DalFSAE/vehicle-control-unit/README.md

<!-- PROJECT LOGO -->
<br />
<div align="center">
  <a href="https://github.com/github_username/repo_name">
    
  </a>

<h3 align="center">Real Time Vehicle Control Unit</h3>

  <p align="center">
    DMS-RTOS-VCU
    <br />
    <a href="https://github.com/AshtonDudley/DMS-RTOS-VCU"><strong>Explore the project »</strong></a>
    <br />
  </p>
</div>

<!-- GETTING STARTED -->
## Getting Started

To get a local copy up and running follow these steps.

### Prerequisites

This is an example of how to list things you need to use the software and how to install them.
* VSCode with the following extensions:
  ```sh
  STM32 VS Code Extension (https://marketplace.visualstudio.com/items?itemName=stmicroelectronics.stm32-vscode-extension)
  Cortex-Debug (https://marketplace.visualstudio.com/items?itemName=marus25.cortex-debug)
  ```
* STM32Cube Tools
    ```sh
    STM32CubeMX (https://www.st.com/en/development-tools/stm32cubemx.html)
    STM32CubeCLT (https://www.st.com/en/development-tools/stm32cubeclt.html)
    ```
* Arm GNU Toolchain
    ```sh
    https://developer.arm.com/downloads/-/arm-gnu-toolchain-downloads
    ```

### Installation
<!--
1. Get a free API Key at [https://example.com](https://example.com)
2. Clone the repo
   ```sh
   git clone https://github.com/github_username/repo_name.git
   ```
3. Install NPM packages
   ```sh
   npm install
   ```
4. Enter your API in `config.js`
   ```js
   const API_KEY = 'ENTER YOUR API';
   ```

<p align="right">(<a href="#readme-top">back to top</a>)</p>
-->

<!-- USAGE EXAMPLES -->
<!--
## Usage

Use this space to show useful examples of how a project can be used. Additional screenshots, code examples and demos work well in this space. You may also link to more resources.
*** _For more examples, please refer to the [Documentation](https://example.com)_

<p align="right">(<a href="#readme-top">back to top</a>)</p>
-->

<!-- CONTRIBUTING -->
## Contributing 
1. Create your Feature Branch (`git checkout -b feature/AmazingFeature`)
2. Commit your Changes (`git commit -m 'Add some AmazingFeature'`)
3. Push to the Branch (`git push origin feature/AmazingFeature`)
4. Open a Pull Request

## Continuous Integration

GitHub Actions validates the firmware build on every push and pull request using the existing CMake `Debug` preset.

To run the same build locally:

```sh
cmake --preset Debug
cmake --build --preset Debug
```

<p align="right">(<a href="#readme-top">back to top</a>)</p>
