DalFSAE/vehicle-control-unit/docs/arm-support.md

# Summary

Building and flashing the project on ARM

## Notes

- Offical ST CLI tool does not work on arm
- Solution, use OpenOCD instead

## Commands Used

```
sudo apt install openocd gcc-arm-none-eabi gdb-multiarch
```
