DalFSAE/vehicle-control-unit/docs/can.md

# CAN Network Design

See also `DalFSAE/can-db` for full documentation.

## Nodes

### can0

- VCU
- INV
- BMS
- HVC
- DASH
- EMETER
- CHRG

### can1

Reserved for future use
