DalFSAE/vehicle-control-unit/docs/architecture/Torque_Control_Process.drawio.pdf

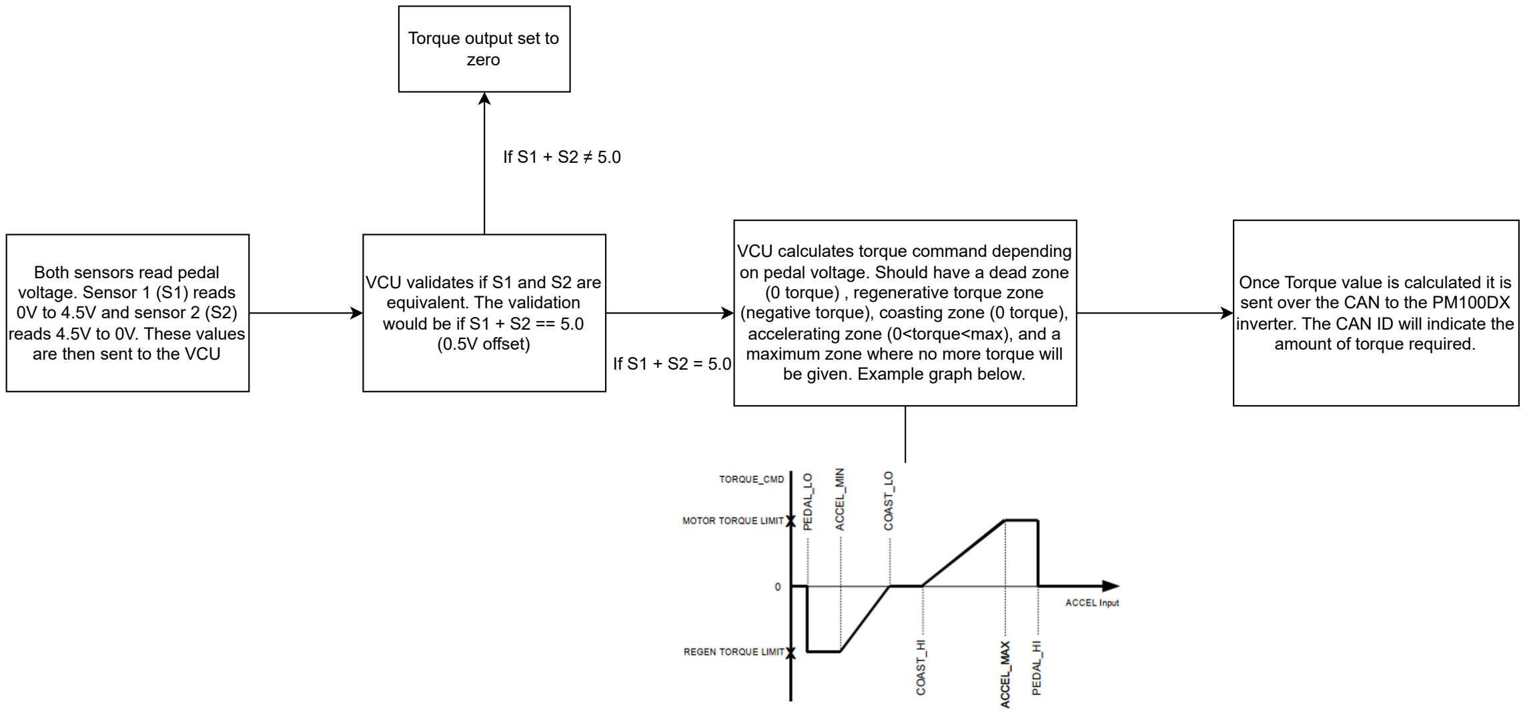
[picture p1: figure]
Both sensors read pedal voltage. Sensor 1 (S1) reads 0V to 4.5V and sensor 2 (S2) reads 4.5V to 0V. These values are then sent to the VCU; VCU validates if S1 and S2 are equivalent. The validation would be if S1 + S2 == 5.0 (0.5V offset); Torque output set to zero; VCU calculates torque command depending; (0 torque) , regenerative torque zone; accelerating zone (0<torque<max), and a maximum zone where no more torque will be given. Example graph below.; Once Torque value is calculated it is sent over the CAN to the PM100DX inverter. The CAN ID will indicate the amount of torque required.

on pedal voltage. Should have a dead zone

(negative torque), coasting zone (0 torque),
