DalFSAE/vehicle-control-unit/scripts/README.md

# Scripts

## Shell

- `can-monitor.sh` — Monitor CAN traffic via USB adapter
- `serial-monitor.sh` — Monitor VCU serial output

## HIL Testing

See [`tools/`](../tools/README.md) for the hardware-in-the-loop test harness.
