DalFSAE/vehicle-control-unit/docs/architecture/VCU_State_Machine_Diagram.png

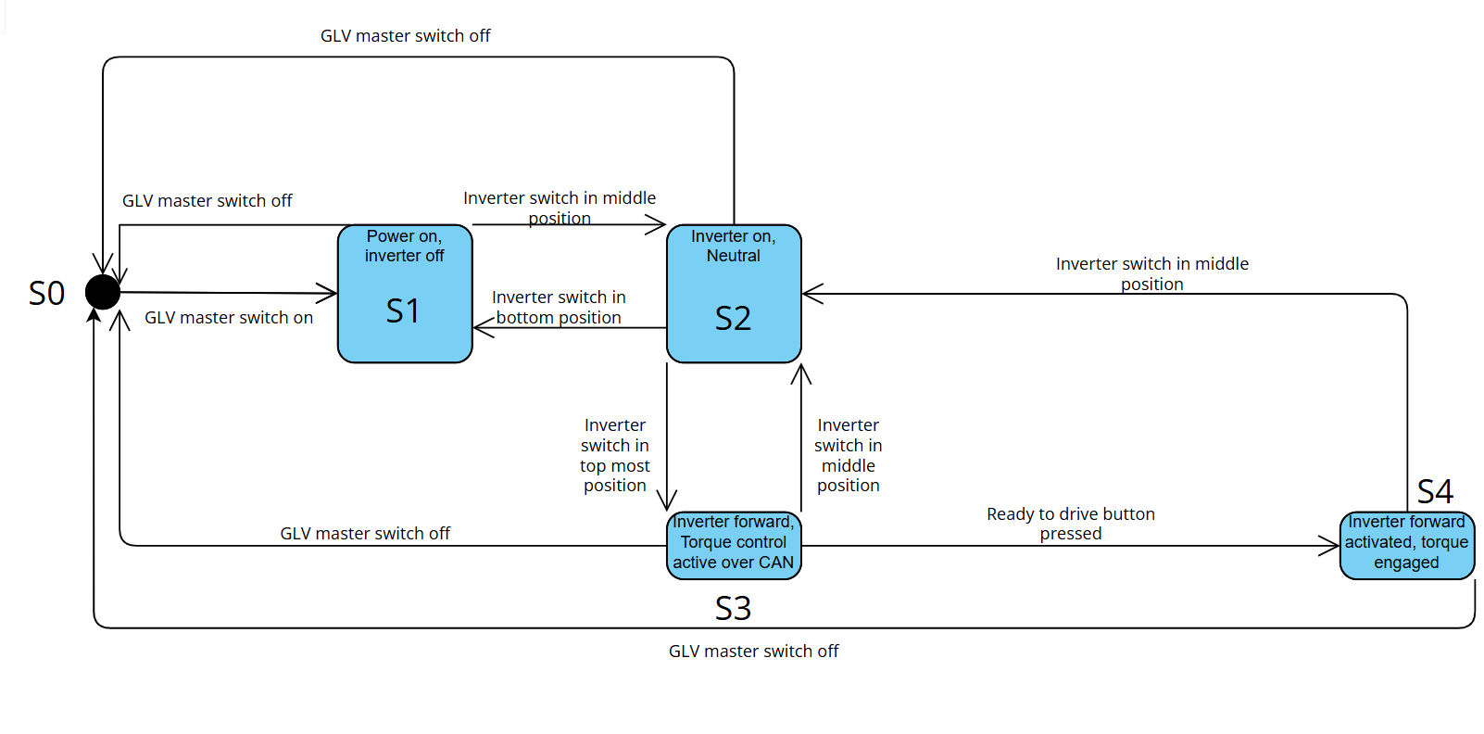
docs/architecture/VCU_State_Machine_Diagram.png
