DalFSAE/vehicle-control-unit/docs/hil-testing.md

# Summary

Hardware-tn-theLoop Testing Plan:

## Mock IO

Goal: create interface to mock the VCUs analog and digitail input/output 

- [ ] Mock apps and brake pressure signals 
- [ ] Mock 

## Mock Tractive System

Goal: provide an interface to a mock tractive system.

- [ ] Interoperate with `DalFSAE/data-and-telemetry` python package
- [ ] Mock CAN responses
- [ ] Mock analog inputs
