DalFSAE/vehicle-control-unit/docs/hardware-revisions.md

# Hardware Revisions

See [Altium 365 (sign in required)](https://americas-dalhousie-formula-sae-dalhousie-university.365.altium.com/designs/folder-CD361B6F-5C06-4D45-AAB6-D6B089EAB05A) for PCB design files.

## Version Code

Meaning:

v1.0.0

## Past Hardware

Only includes manufactured prototypes

| version | vehicle | notes |
| --- | --- | --- |
| v1.0.0  | DMS-24  | did-not-function |
| v1.1.0  | DMS-24  | used at FHE 2024 |
| v2.1.0  | DMS-25  | used at FHE 2025 |
| v3.0.0  | DMS-27  | latest revision (BSPD integrated onto PCB) |
*vehicle control units*
