DalFSAE/vehicle-control-unit/(threads)

Thread 5 (2025-05-05):

Validate functionality of the BSPD

AshtonDudley, 2025-05-05:
The BSPD did not work reliably, and would cause the car to fail during the brakes test. This was fixed by greatly increasing the brake pressure and current signal thresholds.

AshtonDudley, 2025-05-07:
To do this, we would need to open the accumulator and pass a wire through the current sensor.

AshtonDudley, 2025-05-09:
The fault signal of the BSPD is sent to the VCU, but it is not used. It would be useful to log and display the BSPD status on the CAN bus, so that it can be used with the dash

AshtonDudley, 2025-09-03:
We should test the BSPD, and document the results here. Low priority right now, but should be considered when we start working on a new BSPD

Thread 10 (2025-05-09):

Create a V2.1 hardware revision of the VCU

AshtonDudley, 2025-05-09:
# Summary

Create a V2.1 hardware revision of the VCU

## Features

Integrate the STM32F407 onto the PCB
- Removes the need for a bulky development board
- Allows for a smaller PCB
- Easier routing

Improved IO protection
- Include functional bidirectional 5v level shifting
- IO overvoltage and overcurrent protection

More eFuse outputs
- Some of the lower current circuits can be moved to eFuses, reducing PCB size
- eFuses provide better protection in case of a short circuit

Add a 12v barrel jack input for bench development

Consider adding a relay with an exposed coil for the SDC

AshtonDudley, 2025-05-12:
todo: create a new V2.1 project

AshtonDudley, 2025-05-13:
@Lorne-Mac I added a requirements table and created a new project on Altium named DMS-26-VCU-2.2

AshtonDudley, 2025-06-09:
- APPS1 -> ACC2_OPEN -> CAN_BUS -> VCU -> CAN_BUS -> INVERTER (NEVER GOT MADE)
- APPS1 -> VCU ADC -> VCU DAC -> INVERTER (ANALOG), 200ms of throttle

Goal: Apps to invert time to be less than 25ms

## Torque Controller
- See PM100DX datasheet
- Mode 1: Analog, 0- 5V, DIN Brake, DIN Forward, DIN Reverse
- Mode 2: CAN-based control

APPS1 -> VCU: VCU -> CAN_BUS Control message -> INVERTER

Thread 9 (2025-05-09):

Implement VCU CAN bus logging

AshtonDudley, 2025-05-09:
# Summary

Implement CAN bus logging for all critical VCU information. This includes:

- Current VCU state
- All ADC inputs
- The status of all digital inputs and outputs
- Current torque output
- BSPD and Watchdog fault status
