DalFSAE/vehicle-control-unit/DMS-26-VCU-V3.0.pdf

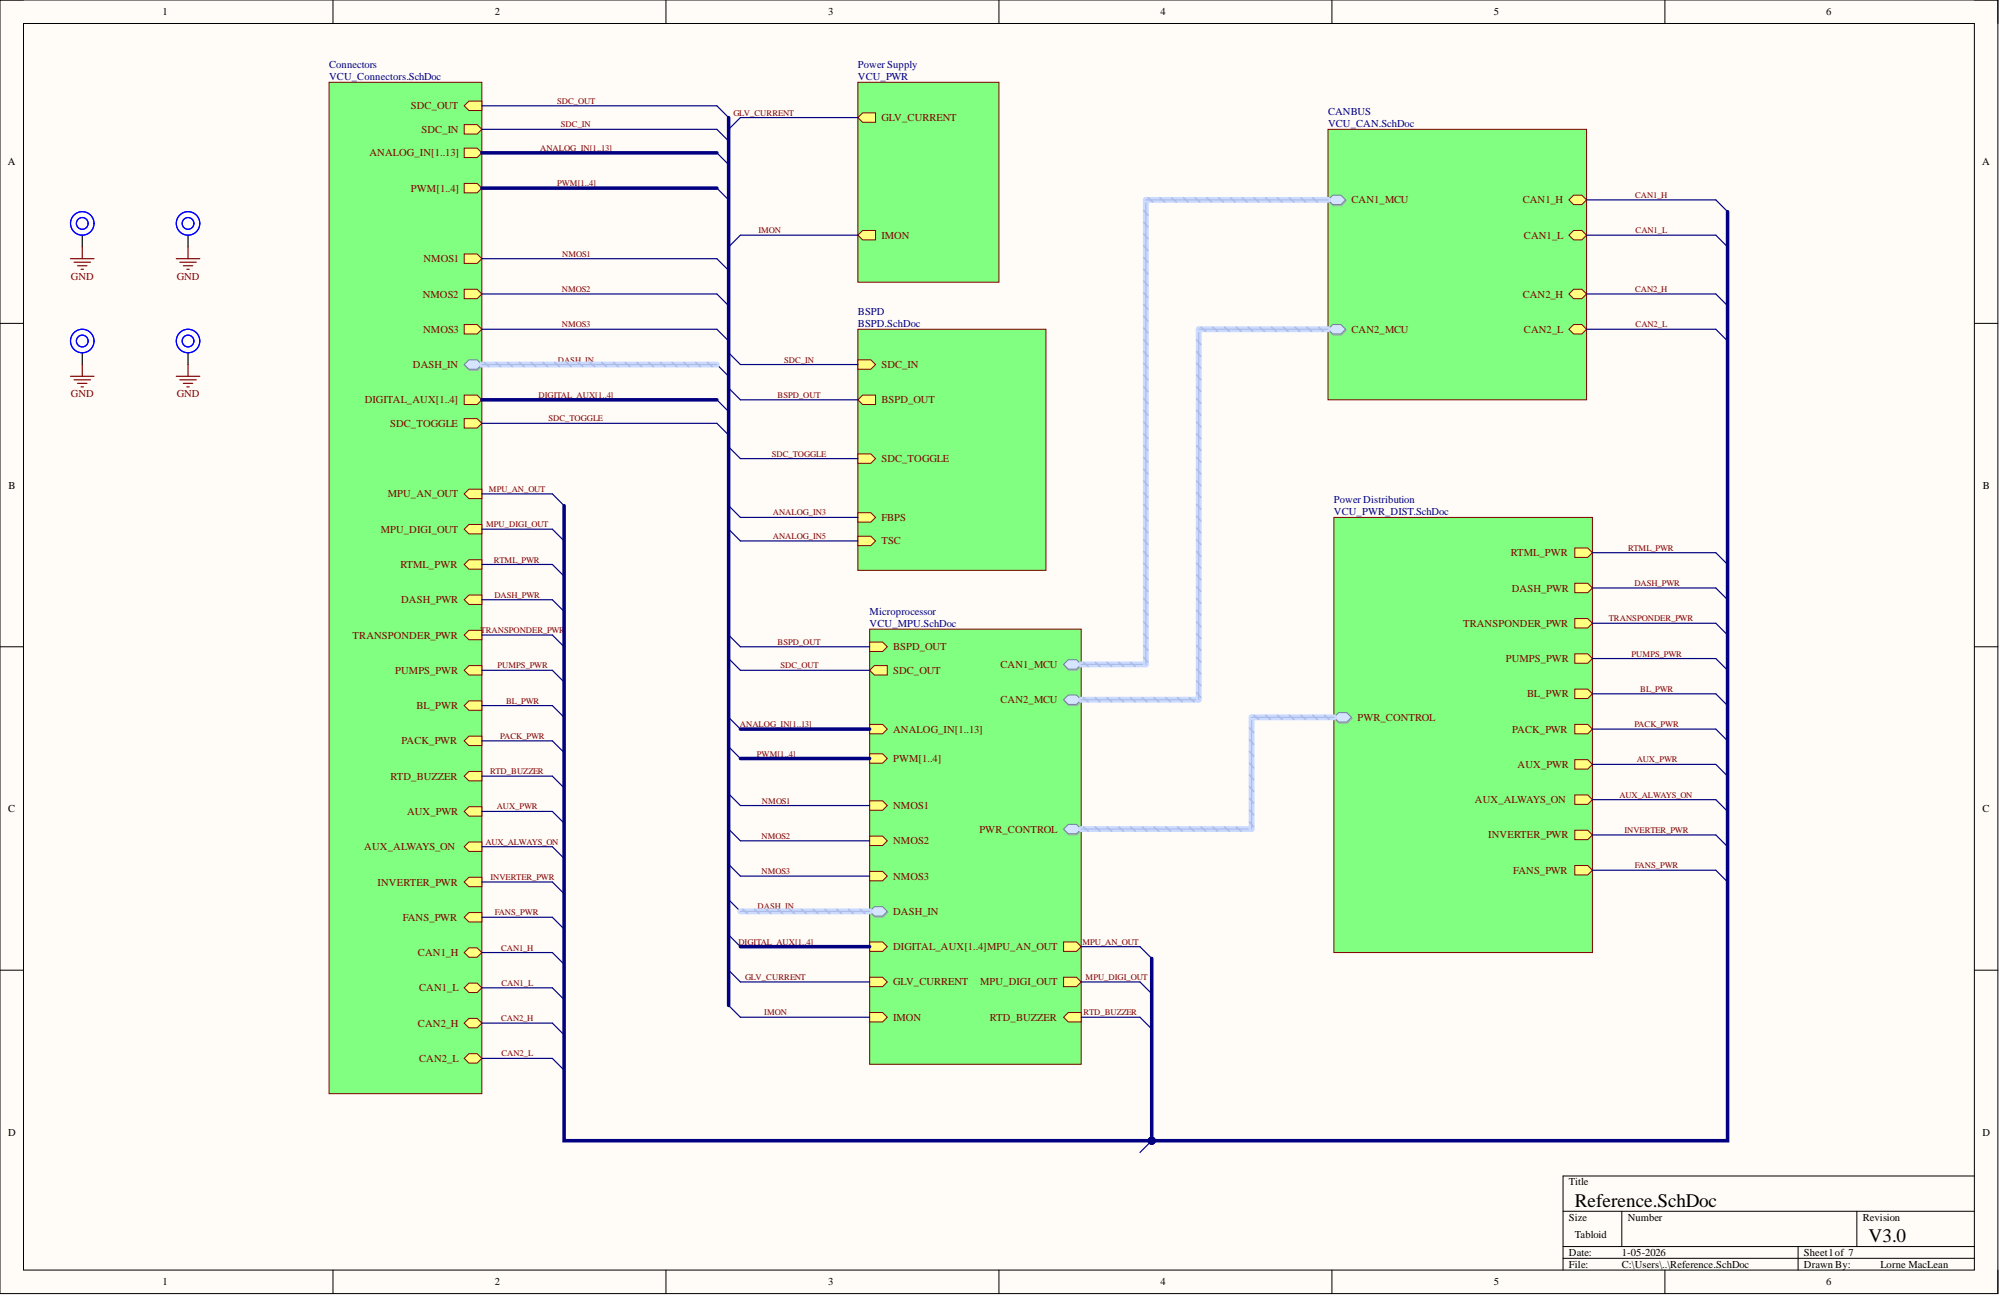
[picture p3: page 1]

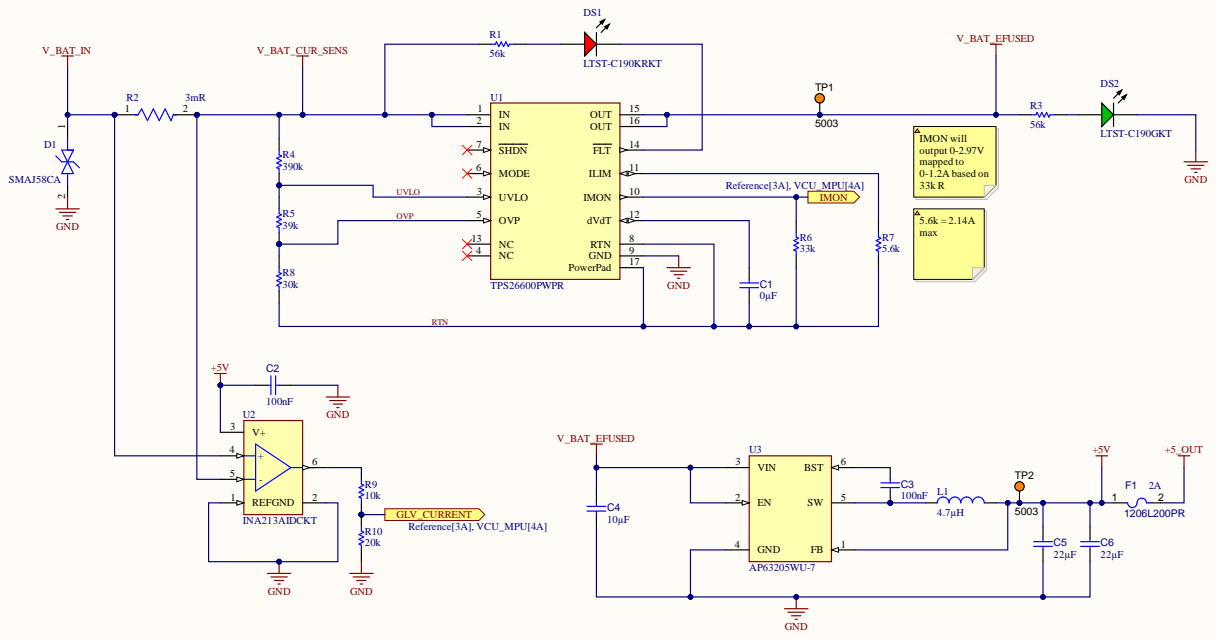
[picture p4: page 2]

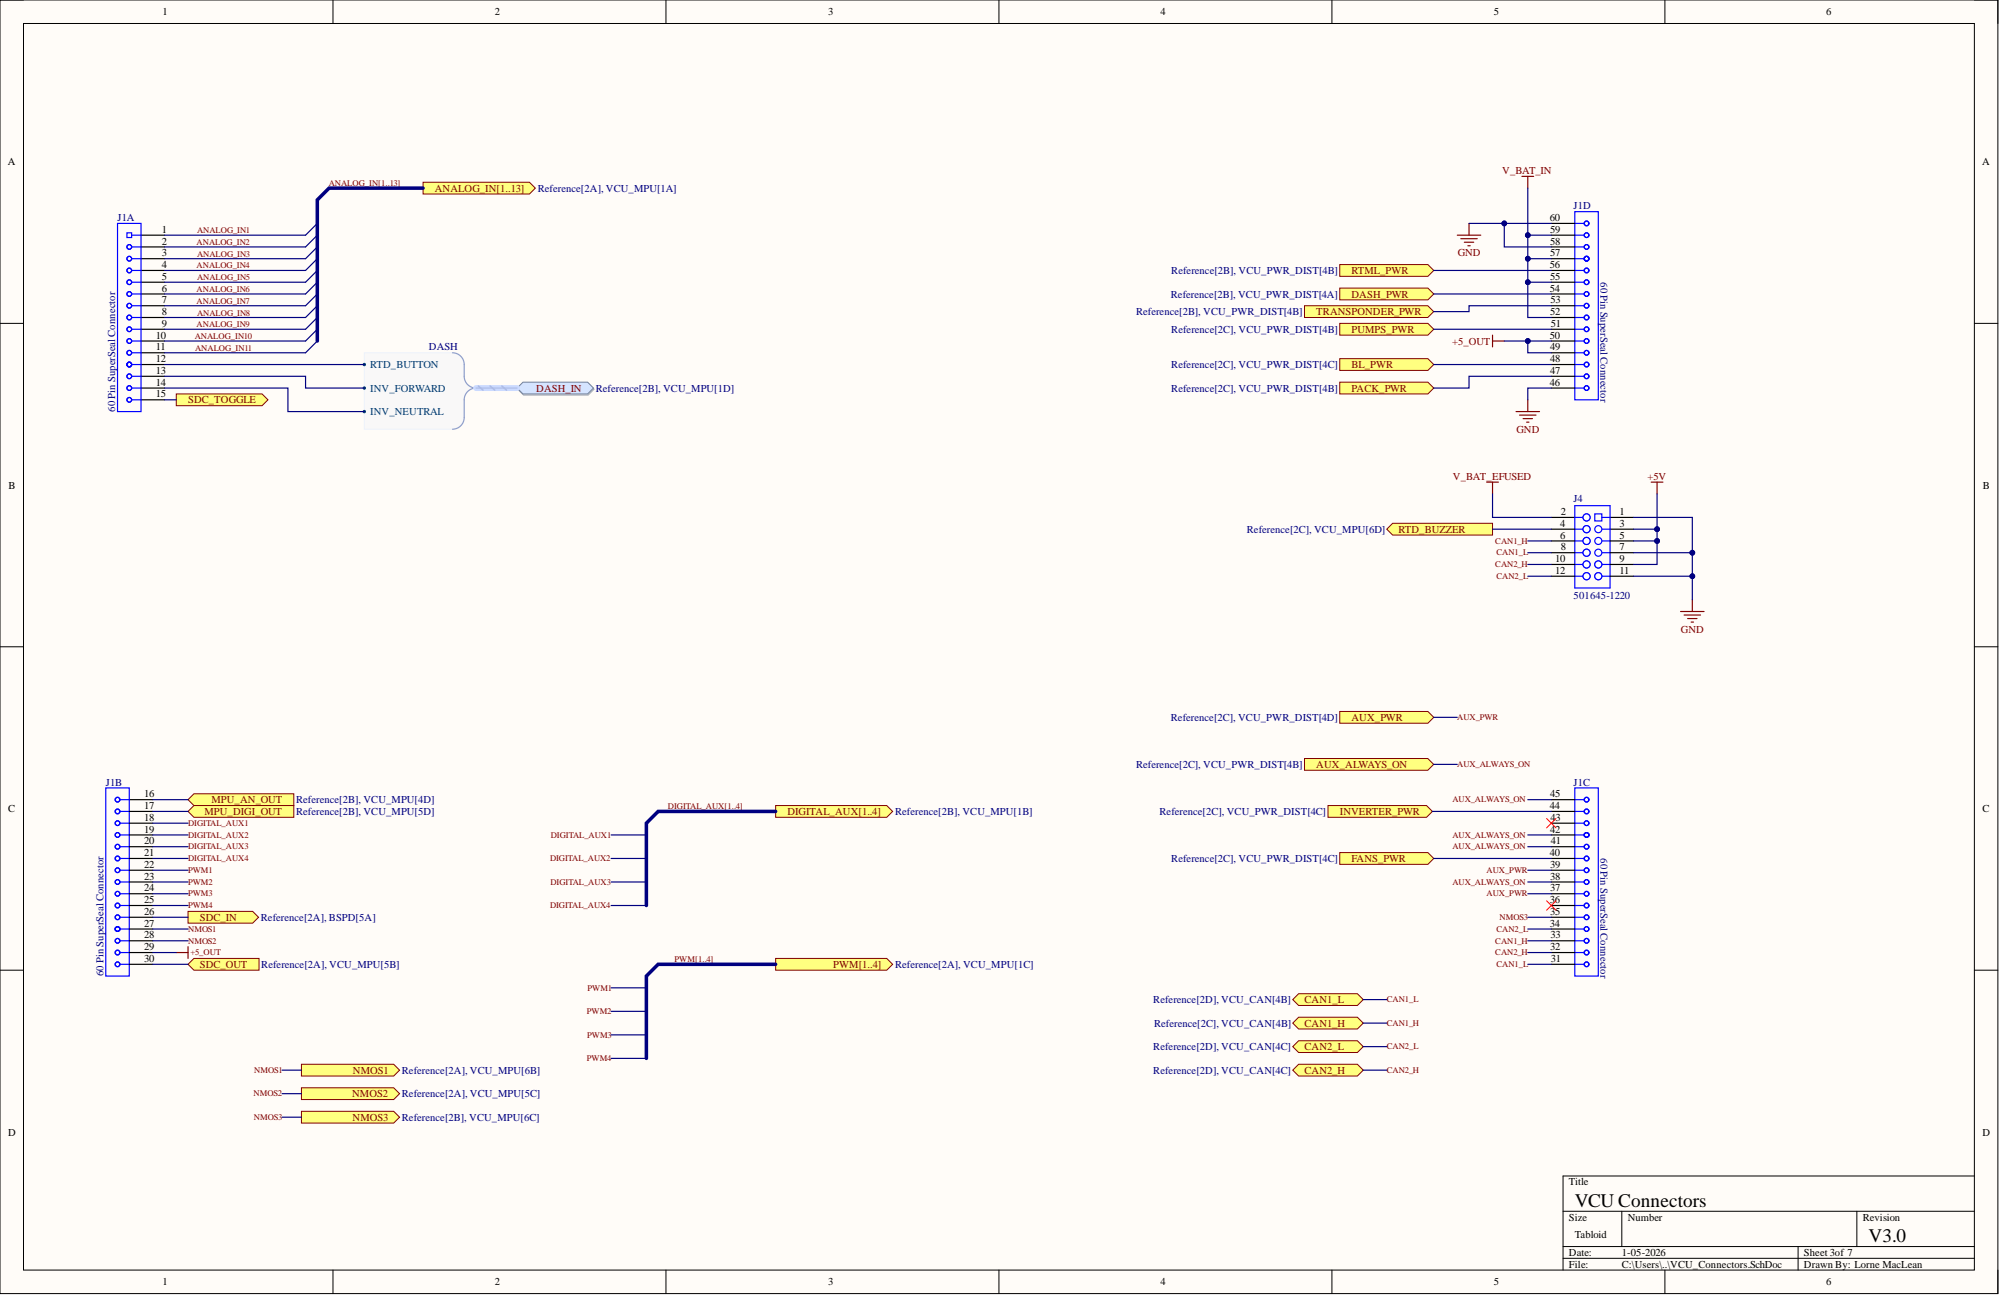
[picture p5: page 3]

SDC_TOGGLE

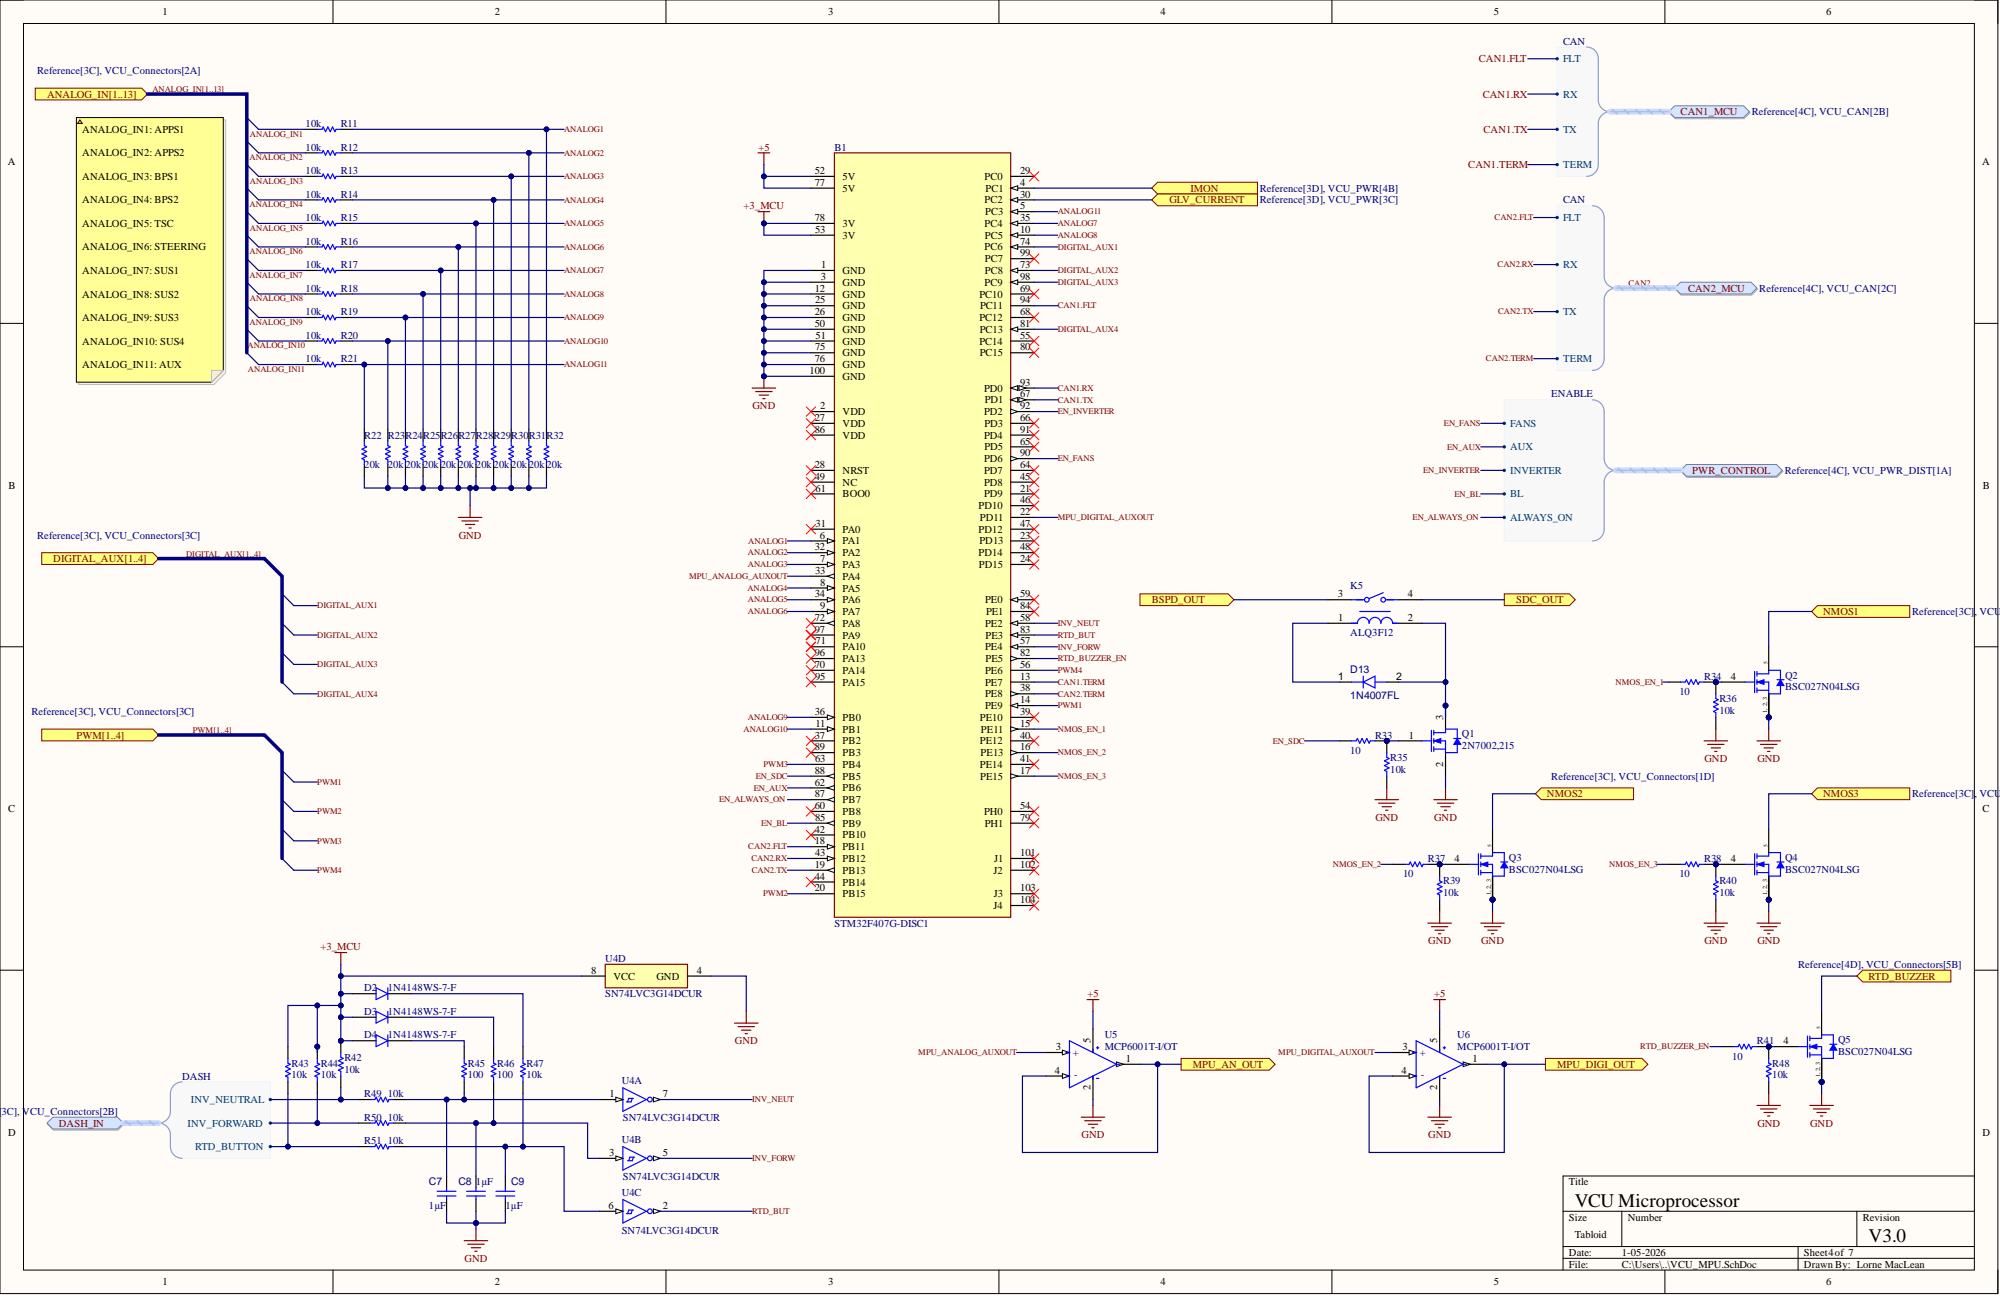
[picture p6: page 4]

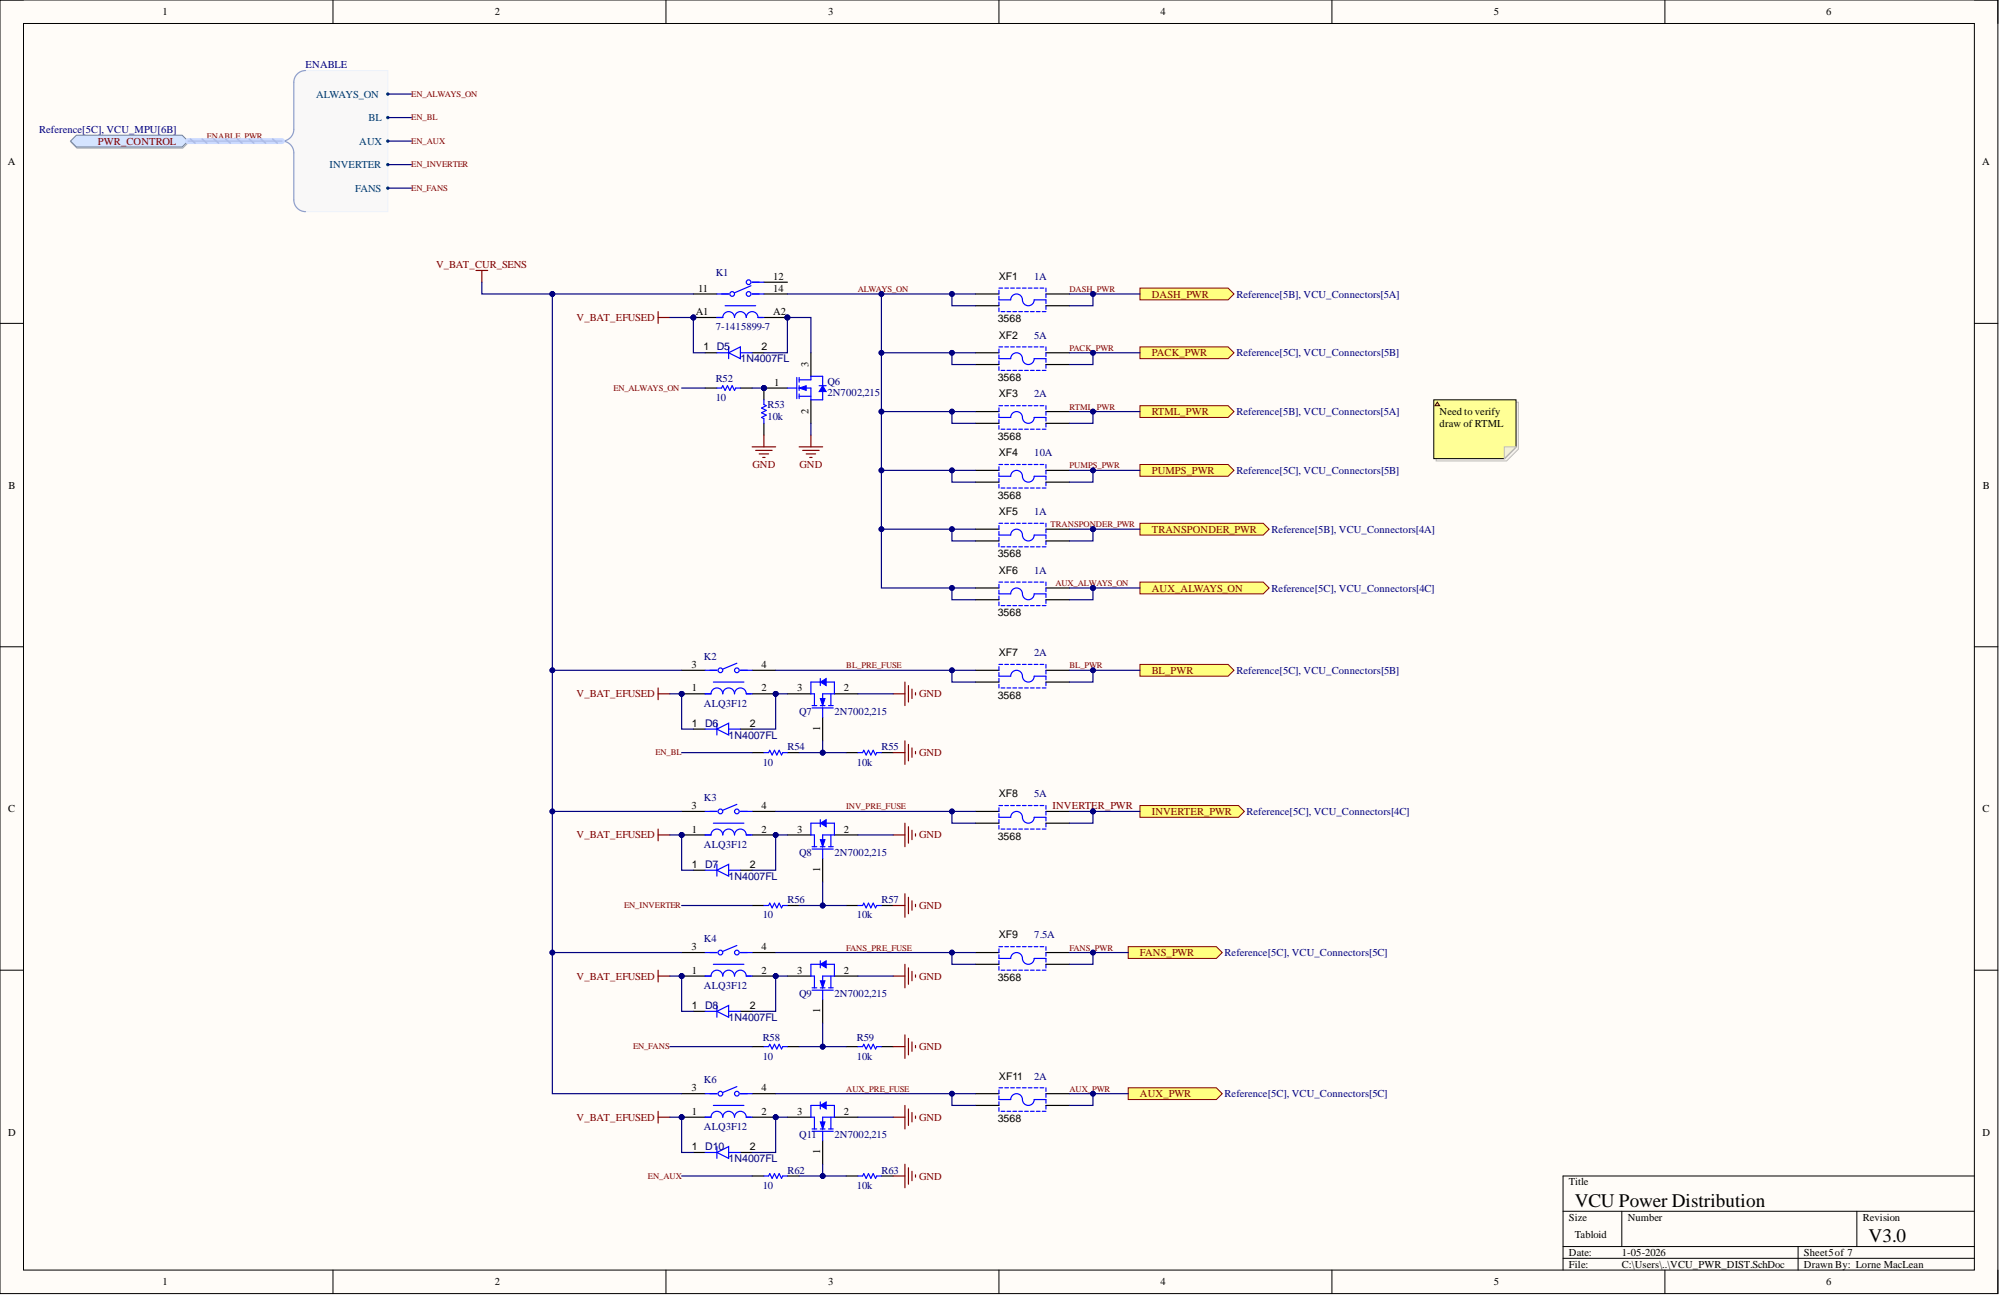
[picture p7: page 5]

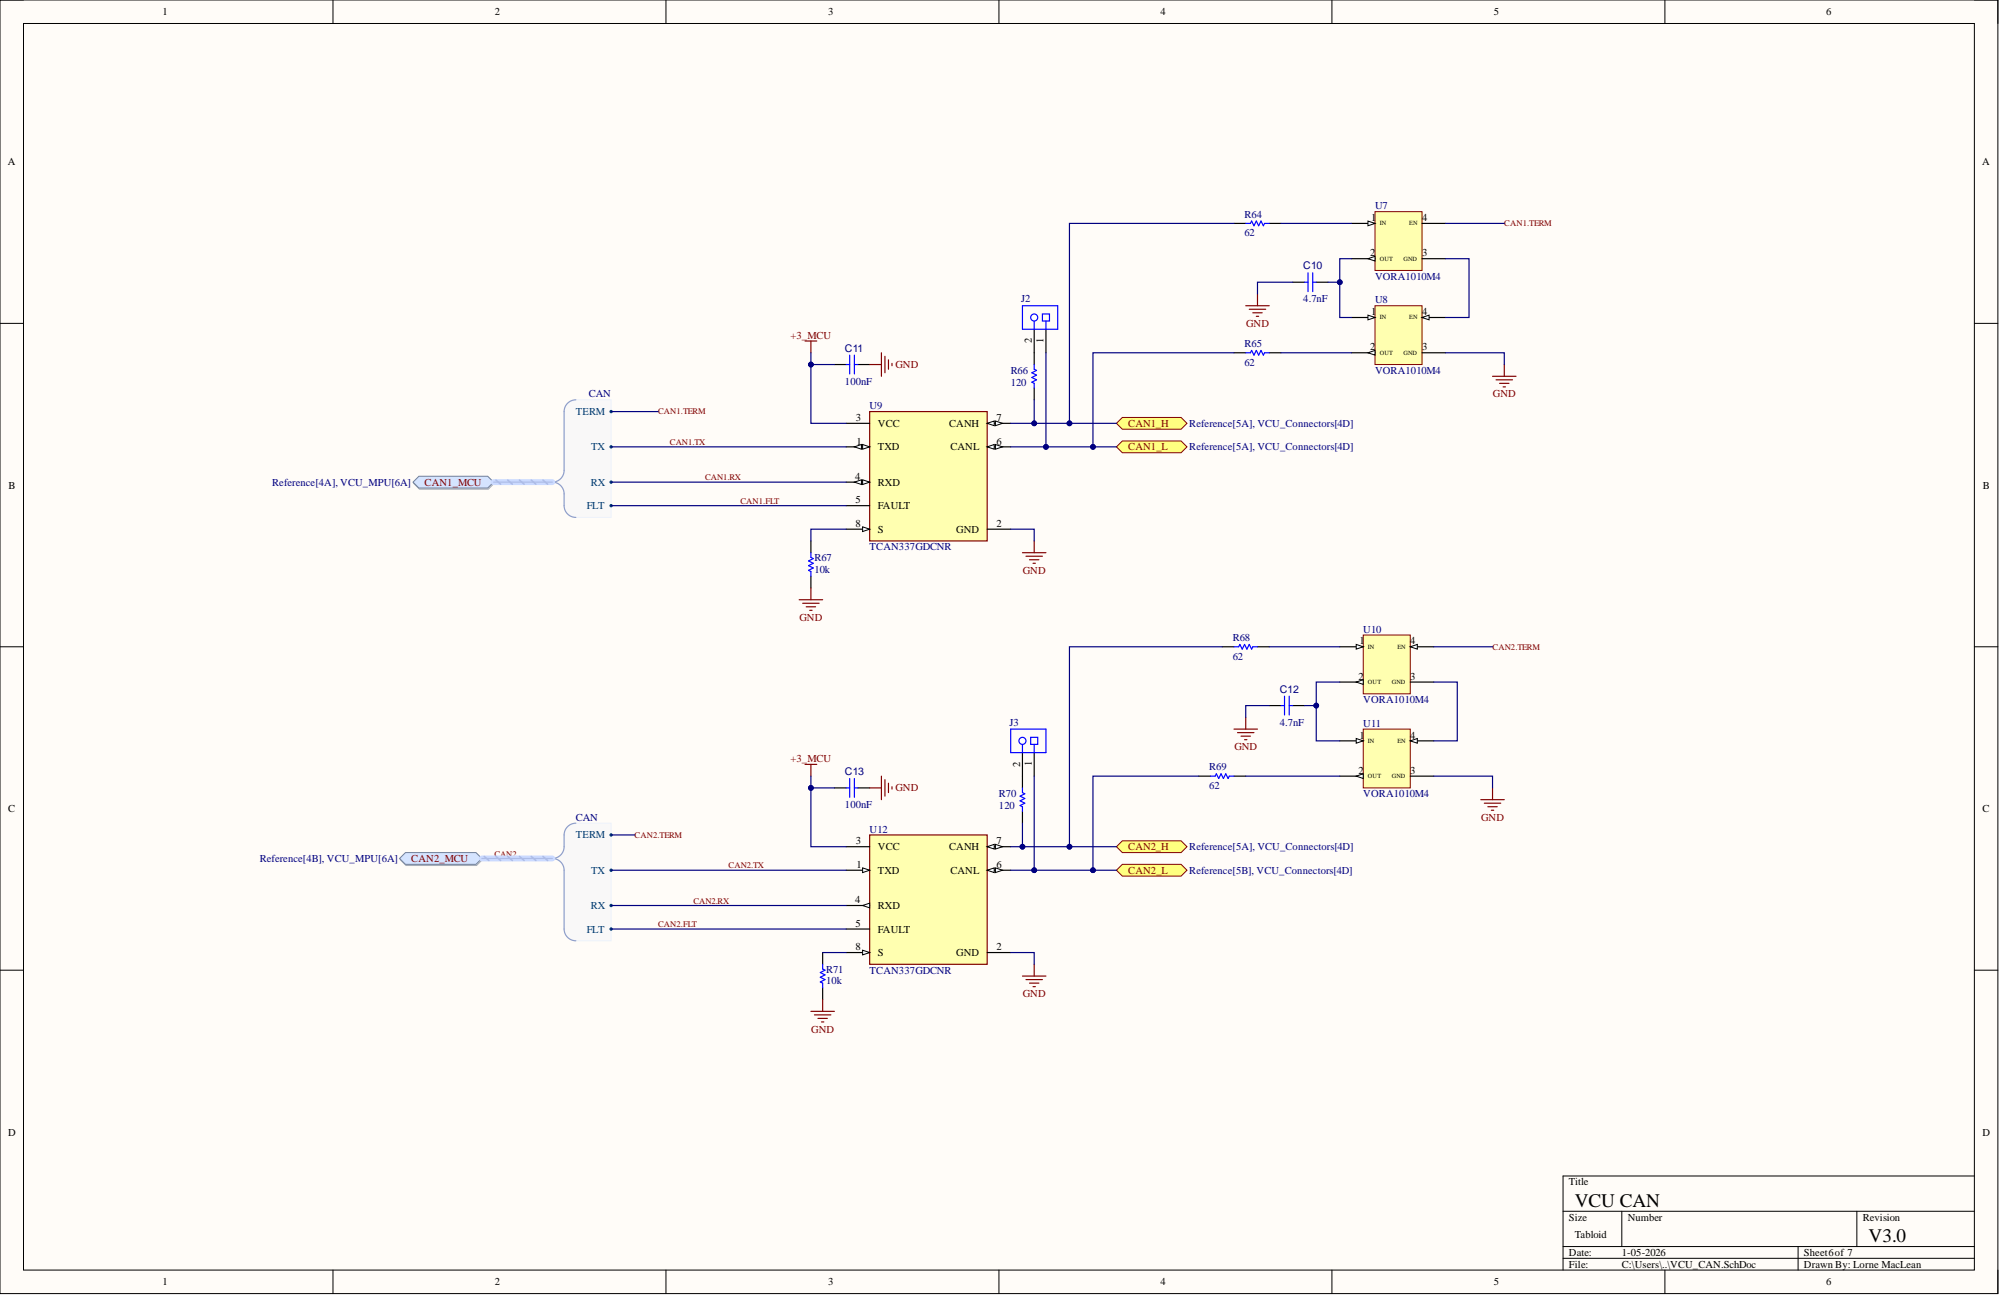
[picture p8: page 6]

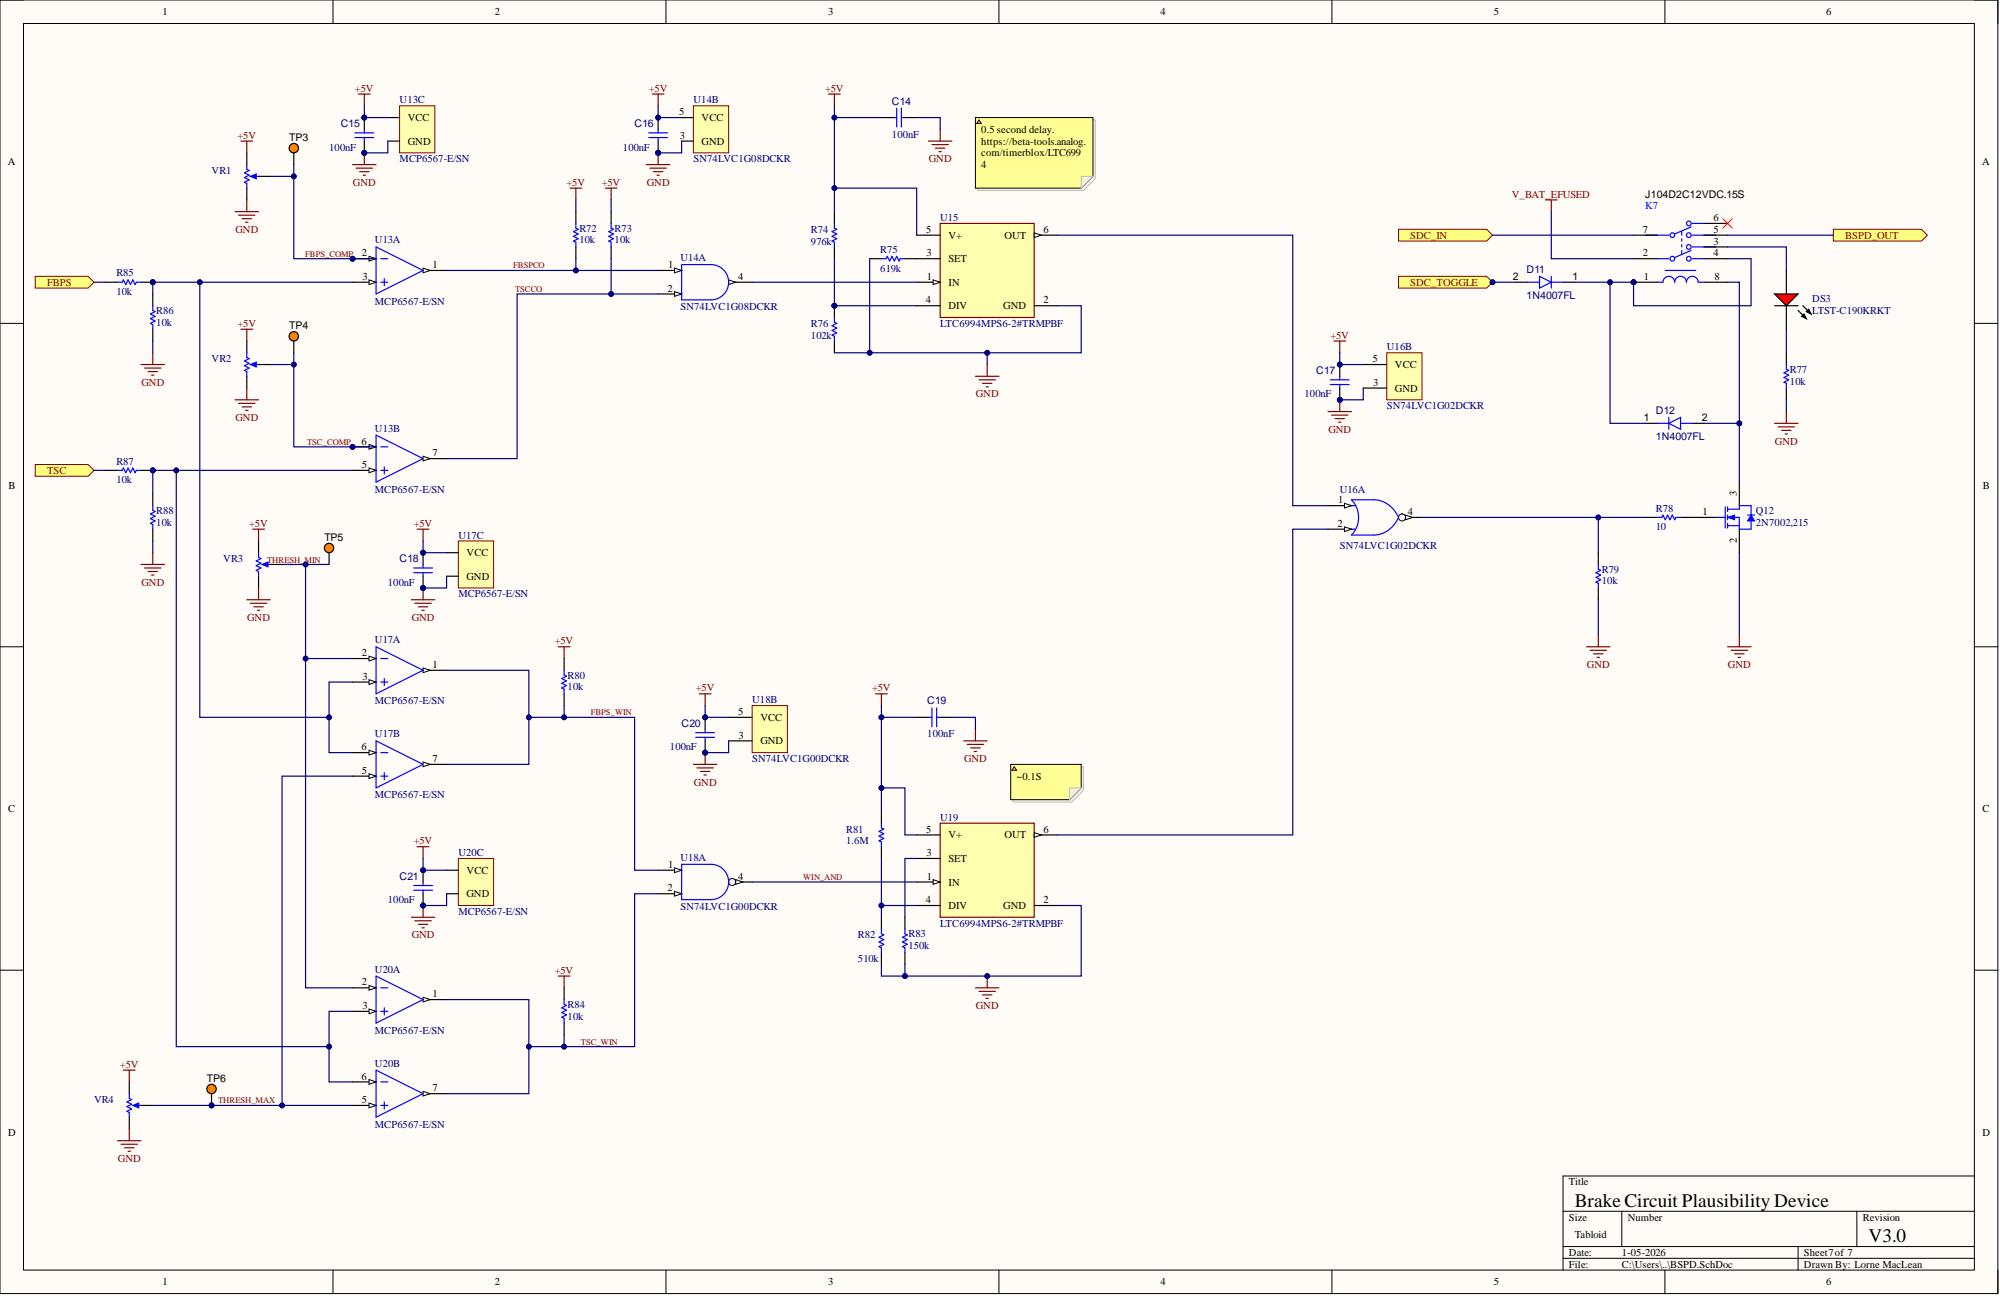
[picture p9: page 7]

Brake Circuit Plausibility Device
