DalFSAE/vehicle-control-unit/Core/User/log.h

#pragma once

#include <stdbool.h>
#include <stdint.h>

#define UART_BUF_SIZE 256
#define LOG_USB_TX_RETRY_COUNT 10U

// CAN payload layout: [event_id(1), source(1), a0[15:8](1), a0[7:0](1),
//                      a1[15:8](1), a1[7:0](1), reserved(1), reserved(1)]
// a0 and a1 are truncated to 16 bits.
#define CAN_PAYLOAD_SIZE 8U

// used to filter log verbosity level
typedef enum {
    LOG_LEVEL_DEBUG = 0u,
    LOG_LEVEL_INFO,
    LOG_LEVEL_WARN,
    LOG_LEVEL_ERROR
} LogLevel_t;

// Only events at or above this level are printed to serial.
#define LOG_MIN_LEVEL LOG_LEVEL_INFO

// List of possible firmware events
typedef enum {
    EVT_BOOT = 0u,
    EVT_STATE_CHANGE,
    EVT_FAULT_SET,
    EVT_FAULT_CLEAR,
    EVT_IO_CHANGE,
    EVT_SENSOR_DEBUG,
    EVT_RTD_ENTERED,
    EVT_COMMAND_REJECTED,
    EVT_TASK_CREATED,
    EVT_HEARTBEAT,
    EVT_FSM_RESET,
    EVT_FSM_STEP,
    EVT_COUNT // must be last
} LogEventId_t;

// List of firmware modules that can produce log events.
// Define LOG_MODULE in each .c file before including log.h:
//   #define LOG_MODULE LOG_SRC_FSM
typedef enum {
    LOG_SRC_UNKNOWN = 0u, // fallback
    LOG_SRC_APP,
    LOG_SRC_FSM,
    LOG_SRC_SENSOR,
    LOG_SRC_PEDAL,
    LOG_SRC_IO,
    LOG_SRC_CAN,
    LOG_SRC_FAULT,
    LOG_SRC_TORQUE,
    LOG_SRC_MC,
    LOG_SRC_LOG,  // log.c itself
    LOG_SRC_COUNT // keep last
} LogSource_t;

// An event is a compact, structured record of something that happened at a
// specific point in time within the firmware.
// Provides a common interface for logging events
typedef struct {
    uint32_t     time_ms;  // time of event
    LogEventId_t event_id; // event id
    LogLevel_t   level;    // verbosity level
    LogSource_t  source;   // event source
    uint32_t     a0;       // logging payload
    uint32_t     a1;       // logging payload
} LogEvent_t;

typedef struct {
    uint32_t len;
    char data[UART_BUF_SIZE];
} LogMsg_t;

// Starts the logging subsystem. Safe to call before the RTOS kernel starts;
// call again from a task context to complete OS-dependent init (mutex).
bool log_init(void);

// Primary event logger — auto-fills timestamp, routes to all sinks
bool log_write(const LogEvent_t *event);

// Optional plain-text printf-style interface for debug output
void log_printf(const char *format, ...);

// Char-at-a-time sink — buffers into lines and forwards to log_printf.
// Safe to call before log_init(); pre-init output is flushed when log_init() runs.
void log_putchar(int c);

// Convenience macro — requires LOG_MODULE to be defined before including this header.
// Falls back to LOG_SRC_UNKNOWN if LOG_MODULE is not defined.
#ifndef LOG_MODULE
#define LOG_MODULE LOG_SRC_UNKNOWN
#endif

#define LOG_EVENT(log_level_value, log_event_id_value, arg0_value, arg1_value) \
    log_write(&(LogEvent_t){                                                   \
        .event_id = (log_event_id_value),                                      \
        .level    = (log_level_value),                                         \
        .source   = LOG_MODULE,                                                \
        .a0       = (arg0_value),                                              \
        .a1       = (arg1_value),                                              \
    })

void log_usb_task(void *argument);
