DalFSAE/vehicle-control-unit/Core/User/fsm_task.c

#define LOG_MODULE LOG_SRC_FSM

#include "fsm_task.h"
#include "fsm.h"
#include "vcu_io.h"
#include "dash.h"
#include "cmsis_os2.h"
#include "log.h"

volatile FsmState_t g_fsm_state     = ST_ENTRY;
volatile bool g_fsm_step_requested  = false;
volatile bool g_fsm_reset_requested = false;

static VcuOutputs s_last_outputs = {0};

FsmState_t fsm_get_state(void) {
    return g_fsm_state;
}

const VcuOutputs *fsm_get_last_outputs(void) {
    return &s_last_outputs;
}

// Packs the boolean output fields into a bitmask for change detection and logging.
// Keep in sync with the EVT_IO_CHANGE formatter in log.c.
static uint32_t pack_outputs(const VcuOutputs *o) {
    return ((uint32_t)o->relay_always_on  << 0u)
         | ((uint32_t)o->relay_inverter   << 1u)
         | ((uint32_t)o->brake_light      << 2u)
         | ((uint32_t)o->mc_brake_sw      << 3u)
         | ((uint32_t)o->can_watchdog     << 4u)
         | ((uint32_t)o->tssi_en          << 5u)
         | ((uint32_t)o->motor_direction  << 6u)
         | ((uint32_t)o->throttle_enabled << 7u);
}

void fsm_task(void *arg) {
    (void)arg;

    const FsmFaultConfig_t fault_cfg = FaultConfig_default();

    FsmState_t state       = ST_ENTRY;
    VcuInputs in           = {0};
    VcuOutputs out         = {0};
    uint32_t prev_out_bits = UINT32_MAX; // force log on first cycle

    for (;;) {
        if (g_fsm_reset_requested) {
            g_fsm_reset_requested = false;
            LOG_EVENT(LOG_LEVEL_INFO, EVT_FSM_RESET, state, ST_ENTRY);
            state = ST_ENTRY;
            vcu_clear_spoof();
        }

        vcu_gather_inputs(&in);
        out = (VcuOutputs){0};
        out.debug_leds = in.debug_cmd;
        FsmState_t next = step_fsm(state, &fault_cfg, &in, &out);

        if (next != state) {
            LOG_EVENT(LOG_LEVEL_INFO, EVT_STATE_CHANGE, state, next);
        }

        uint32_t out_bits = pack_outputs(&out);
        if (out_bits != prev_out_bits) {
            LOG_EVENT(LOG_LEVEL_DEBUG, EVT_IO_CHANGE, out_bits, (uint32_t)(out.throttle_request * 1000.0f));
            prev_out_bits = out_bits;
        }

        s_last_outputs = out;
        state          = next;
        g_fsm_state    = state;

        vcu_apply_outputs(&out);

        if (g_fsm_step_requested) {
            g_fsm_step_requested = false;
            LOG_EVENT(LOG_LEVEL_DEBUG, EVT_FSM_STEP, state, 0);
        } else {
            osDelay(FSM_PERIOD_MS);
        }
    }
}
