DalFSAE/vehicle-control-unit/Core/Tests/hardware/test_fsm_hil.h

#pragma once

void test_fsm_in_standby_after_boot(void);
void test_fsm_standby_requires_switch_and_ts(void);
void test_fsm_transitions_to_neutral(void);
void test_fsm_rtd_requires_brake(void);
void test_fsm_rtd_with_brake_enters_forward(void);
void test_fsm_pedal_plaus_returns_to_neutral(void);
void test_if_debug_button_changes_state(void);
void test_throttle_step_response_from_nuetral(void);
void test_throttle_step_response_from_forward(void);
