DalFSAE/vehicle-control-unit/Core/Tests/hardware/test_usb_cmd.h

#pragma once

void test_usb_cmd_echo_roundtrip(void);
void test_usb_cmd_request_state(void);
void test_usb_cmd_request_outputs(void);
void test_usb_cmd_spoof_set(void);
void test_usb_cmd_step(void);
void test_usb_cmd_reset(void);
