DalFSAE/vehicle-control-unit/(commit log)

2025-04-12 Testing Relay Functions
2025-04-12 Relays Clicking!
2025-04-12 working relay controls
2025-04-12 moved output throttle to function
2025-04-14 Updated ADC list
2025-04-14 removing throttle sensor
2025-04-14 DAC out from ADC input value, no scaling
2025-04-23 trying to add switch debounce
2026-04-27 Switched to new .ioc file (#39)
    * Changed out ioc file for the new one
    * Updated ioc file to include an analog output pin
    * Updated IOC file to new version
    * Hw 3.0 add drivers (#42)
    * Added drivers generated by CubeMX
    * Added middleware generated by CubeMX
    * Added generated .c/.h files
    * Updated .ioc file and generated code
    * Added FreeRTOS to .ioc
    * VSCode Settings
    ---------
2026-04-27 Vcu 3.0 blinky (#43)
    * Added DMA to ioc
    * Updated for freertos
    * Created file
    * basic app structure
    * updated main
    * Generated from ioc
    * Updated .gitignore
    * Stop tracking generated files
    * Working build with blinking LED and RTOS
    * Updated .ioc file an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
2026-04-30 Fix `.vscode` on Linux (#53)
    * added unity tasks
    * Working VSCode config for STM32F407 (tested on Arch Linux)
    further testing will be done on ubuntu and windows later
2026-04-30 Added windows specific settings to VSCode (#58)
    * Added windows specific settings to VSCode
    * Removed windows specific settings
    Now ${config:STM32VSCodeExtension.cubeCLT.path} in launch.json will fall through to user settings (c:\ST\STM32CubeCLT_1.15.1) and the GDB server path will resolve correctly. Linux users will need TM32VSCodeExtension.cubeCLT.path set in their own user settings. the STM32 extension typically auto-detects and writes this on first install, so it should already be there for anyone who set up the extension properly.
    * Add OS-specific toolchain paths to launch.json
    Replace top-level STM32CubeCLT path settings with per-OS windows/linux blocks in .vscode/launch.json for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
2026-05-31 Added docs from various sources (#76)
    * added docs from DMS-26-CAD
    * Added template from `vehicles`.
    * Create vcu-finite-state-machine.md
    * Added architecture document for the VCU-FSM
    * Added more architecture documents
    * Squashed commit of the following:
    commit ed64baf494b836791ac9803a28ba2f3805dc4a3f
    Author: Ashton Dudley <adudley@dal.ca>
    Date: Sun May 3 21:07:05 2026 -0300
    Cleanup code from testing session (#74)
    * Moved can handle to `app.c`
    * Moved state struct to `vcu_io.h`
    * Fixed issue with ISR and logging
    Log function is not thread safe, to deal with, moved logging to CAN task
    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
